ongaroleandro/autonomous-mobile-robot/media/footprint_all_points.png

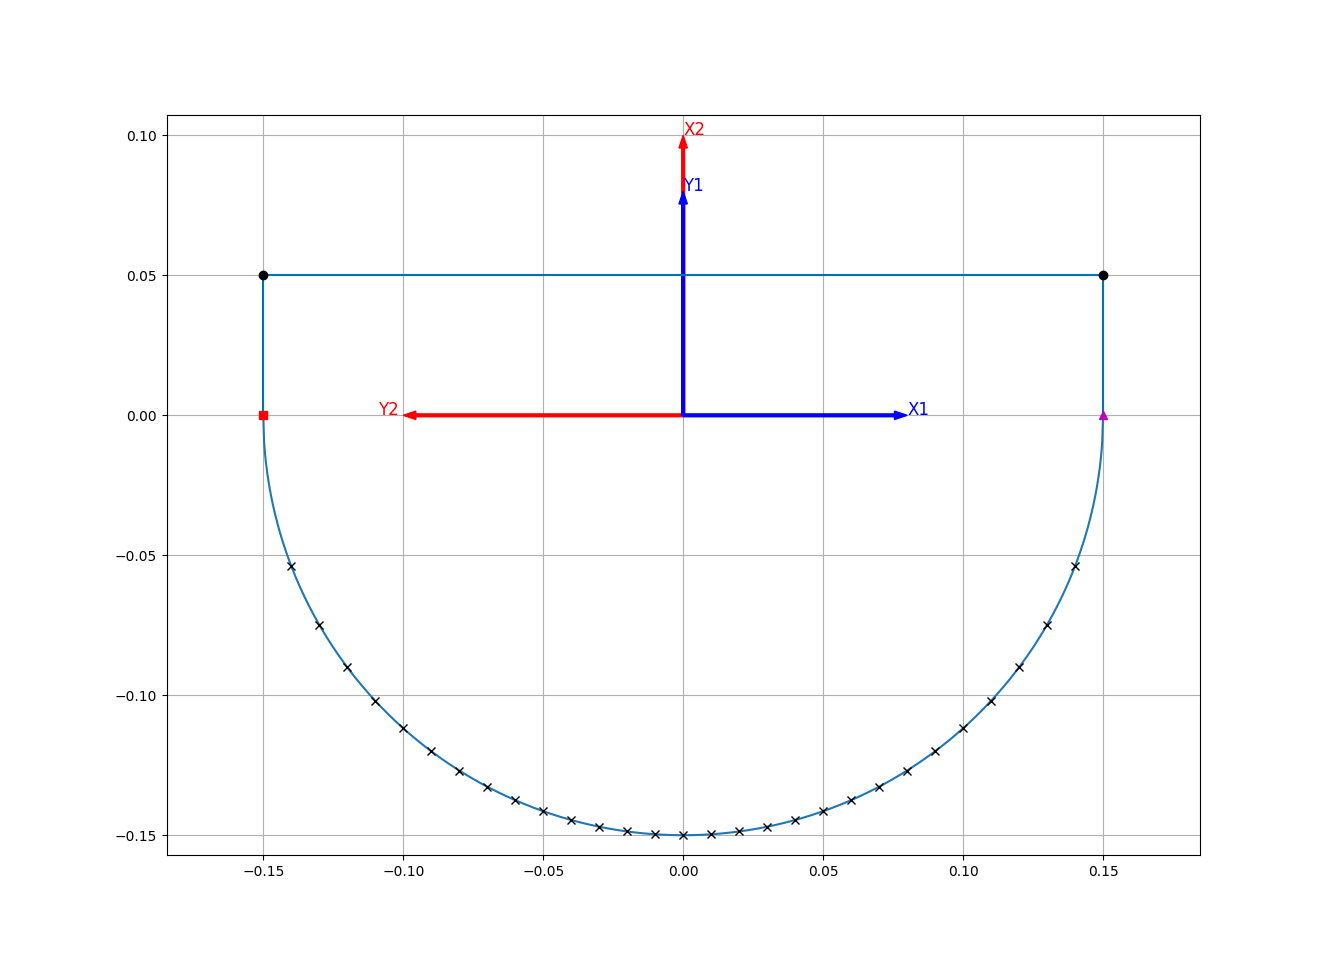
media/footprint_all_points.png
