ongaroleandro/autonomous-mobile-robot/media/footprint_rotmat.png

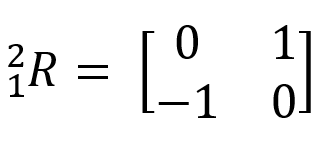
media/footprint_rotmat.png
