ongaroleandro/autonomous-mobile-robot/media/mobile robot v1.jpg

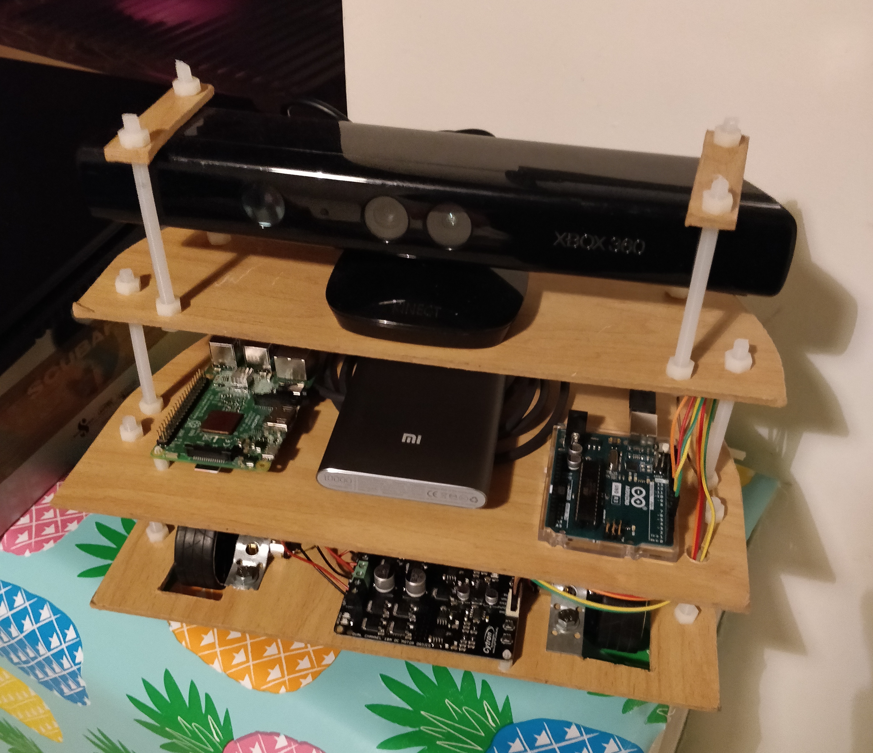
media/mobile robot v1.jpg
