ongaroleandro/autonomous-mobile-robot/media/velocity_vectors.JPG.jpg

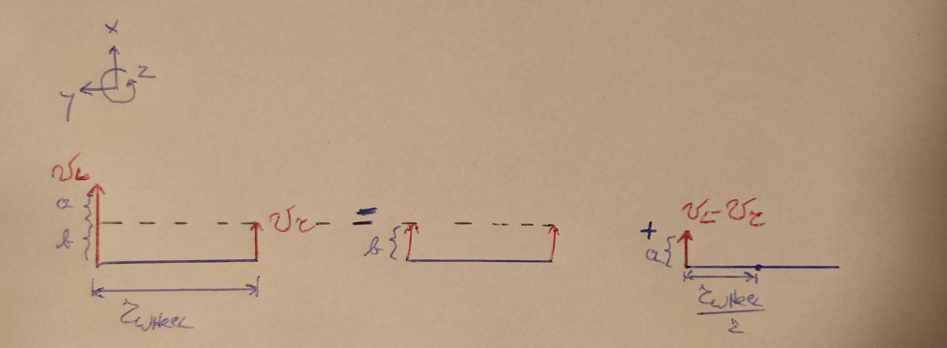
media/velocity_vectors.JPG.jpg
