ongaroleandro/autonomous-mobile-robot/CAD files and technical drawings/bottom plate.PDF

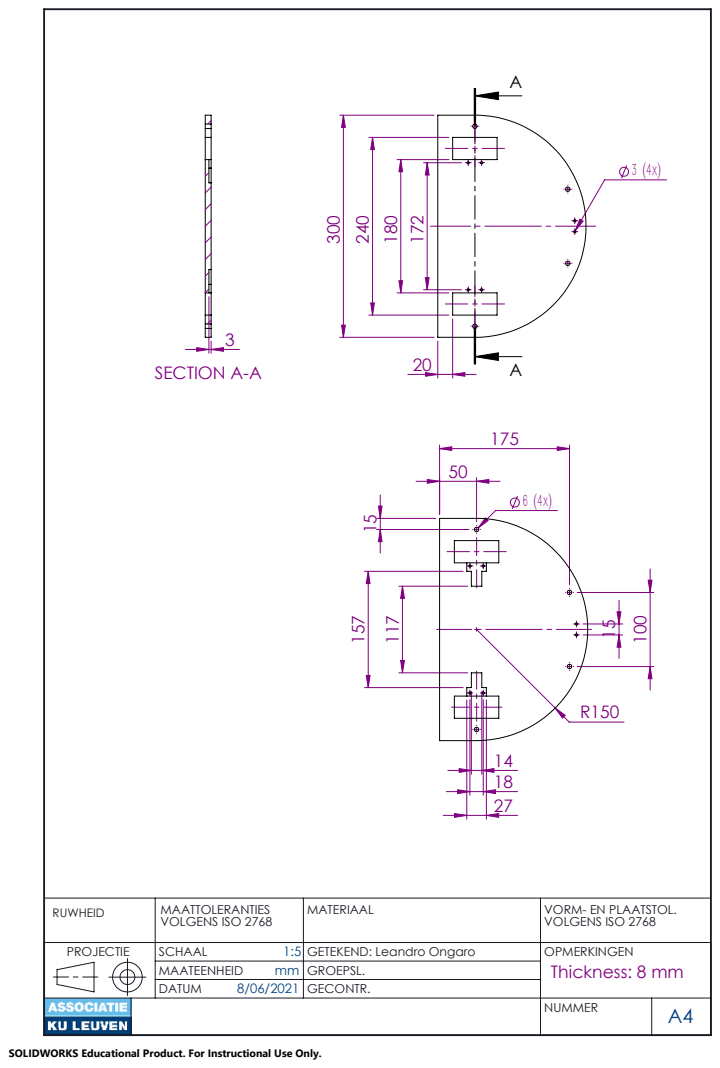
[picture p12: page 1]
SECTION A-A

RUWHEID | MAATTOLERANTIES VOLGENS ISO 2768 | MATERIAAL | VORM- EN PLAATSTOL. VOLGENS ISO 2768
PROJECTIE | SCHAAL 1:5 | GETEKEND: Leandro Ongaro | OPMERKINGEN Thickness: 8 mm

mm MAATEENHEID | GROEPSL.
DATUM 8/06/2021 | GECONTR.

NUMMER | A4

SOLIDWORKS Educational Product. For Instructional Use Only.
