ongaroleandro/autonomous-mobile-robot/CAD files and technical drawings/kinect holder.PDF

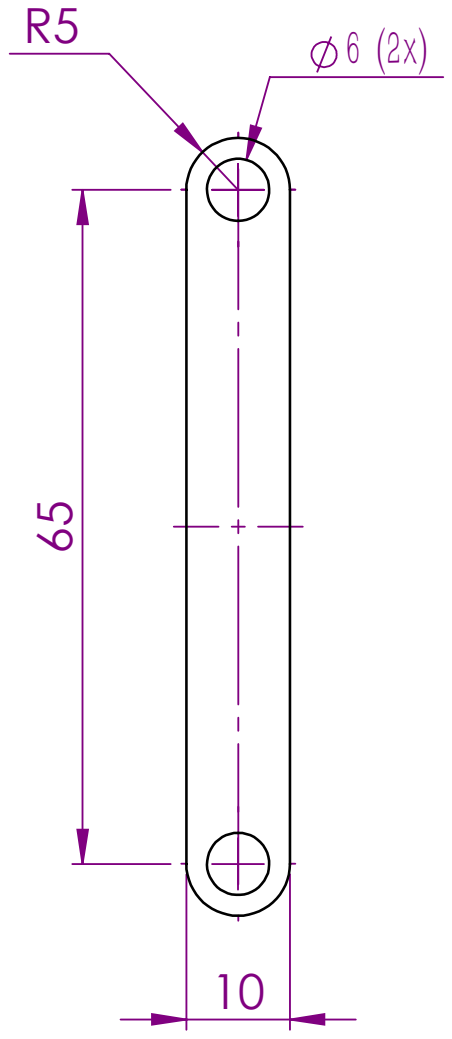
[picture p13: page 1]

RUWHEID | MAATTOLERANTIES VOLGENS ISO 2768 | MATERIAAL | VORM- EN PLAATSTOL. VOLGENS ISO 2768
PROJECTIE | SCHAAL 1:1 | GETEKEND: Leandro Ongaro | OPMERKINGEN Thickness: 3 mm

mm MAATEENHEID | GROEPSL.
DATUM 5/06/2021 | GECONTR.

NUMMER | A4

SOLIDWORKS Educational Product. For Instructional Use Only.
