ongaroleandro/autonomous-mobile-robot/(commit log)

2021-02-28 updated 'communication between RPI and Arduino'
2021-02-28 Added motor-control-mobile-robot.ino and mobile robot v1.jpg
2021-03-01 updated motor-control-mobile-robot.ino
2021-03-04 added node to collect arduino data and updated motor-control-mobile-robot.ino
2021-03-10 changed first remap to camera/depth_registered/image_raw
2021-03-11 added code to read encoders
2021-03-20 only publish topics when encoder is running
2021-03-20 added pose from odometry code
2021-03-20 changed for testing with 'motor-control-and-reading-encoder.ino'
2021-04-10 Reading encoders works correctly now
    Removed MD_REncoder and implemented the encoder library from 1988Kramer.
    Also changed the array (from 5 elements to 3 elements) to accomodate for
    changing to the encoder library from 1988Kramer.
    [motor-control-and-reading-encoder.ino]
2021-04-10 Fixed a mistake when defining the encoder objects
    1140 times two is 2280 and not 2240...
    [motor-control-and-reading-encoder.ino]
2021-04-10 Added reading motor encoders
2021-04-14 Published message now contains usable time in sec.
    nh.now().toSec() is too big for the arduino to handle so for the
    time being we split the number in a hacky way.
    [motor-control-and-reading-encoder.ino]
2021-04-15 Updated code to accept 1x3 array message
    Also added an if statement for when the subscriber node receives
    its first message since we handle sending the time on the arduino
    in a hacky way for the time being.
2021-04-15 Updated reading motor encoders & navigation stack
    Updated the sections 'arduino code for reading motor encoders' and 'first iteration of python code' to the current code.
2021-04-15 Integrated odom publisher in odometry-calculation.py
    This script has the necessary code to publish the odometry we
    calculated.
2021-04-15 Created 'odometry' package
    This package was created because additional dependencies were
    needed to run odometry_handler.py
2021-04-16 Added section on publishing odometry information
2021-04-24 Classes for navigation stack
    Implementation of classes for handling odometry.
2021-04-28 Included freenect_launch
    Instead of launching 'freenect.launch' in a seperate terminal window we launch 'freenect-registered-xyzrgb.launch' from within this launch file.
    By including 'freenect-registered-xyzrgb.launch' we can also run our OdometryHandler (i.e foobar.py)
2021-04-29 Added section:'Calculating the twist from odometry'
    Also updated the 'Publishing odometry information' section.
2021-05-11 Converting speed to a duty cycle is now more correct
    After some testing I found that supplying the motor with
    12 V (so 100% duty cycle) gives a linear velocity of 0.2 m/s.
    6 V (so 50% duty cycle) gives about half the linear velocity.
    So assuming the full range has a linear relationship between duty
    cycle and velocity, I calculated the slope so we can easily convert
    motor speed to a duty cycle.
    [motor-control-and-reading-encoder.ino]
2021-06-04 Final code for publishing odometry
    OdometryHandler.py will start the main odometry handler node.
2021-06-05 Added cad files and technical drawings
2021-06-05 updated several sections
    Text is changed to reflect that we're now using classes for publishing odometry.
    Also added text on the robot design
2021-06-20 Created etbot package and move_base launch file.
    The 'etbot' package is the main package of our robot.
    It has the necessary config files (they end with .yaml) for the navigation stack.
    The package also contains the launch file 'etbot_config'. This file launches the odometry
    node, the rosserial_arduino node, freenect_stack and the static tf broadcaster.
    The move_base launch file start the map_server and AMCL.
2021-06-26 plots used in the wiki page 'footprint calculation'
2021-06-26 Two additional images used in the 'footprint calculation' wiki page
2021-06-26 Updated config files
    costmap_common_params.yaml:
    changed base_footprint to better represent the actual robot footprint
    global_costmap_params.yaml:
    deleted the 'map_type' parameter, since this is not used
2021-06-28 Changed baudrate of rosserial_arduino to 57600.
    Changing baudrate from 115200 to 57600 resolves the check sum error.
    The check sum error was a result of the raspberry not being able
    to keep up because of the high baudrate.
2021-06-28 Cleaned up the code for OdometryHandler_collect_data
    Removed uncommented code
    Tab size across three three files is now consistent (1 tab = 4 spaces)
2021-06-28 Files used to choose a baudrate and calculate the variance
    [data_115200.csv, data_38400.csv, data_57600.csv]
2021-06-28 Code used for wiki page `Footprint calculation`
    This has all the code used to generate the different images as
    well as the code to calculate the point for the footprint
    Uncommenting the various `plt.show()` will give you the different
    images.
2021-06-29 Changed `OdometryHandler.py` and `dataprocessor.py`
    1. Updated the rate in `OdometryHandler.py`
    2. The the angle calculation in `dataprocessor.py` is now done correctly.
    Previously the angle would either become bigger than 360° or become
    smaller than -360°. Now The angle stays between -359° and 359°
2021-06-29 The correct odometry node is now launched.
    Previously `foobar.py` would get launched, but this was the old
    filename of the odometry node. Now `OdometryHandler.py` is launched
    which is the current filename.
2021-06-30 Expanded funcionality
    Regarding the CommandCenter class:
    - added several new instance variables
    - `publish_reset()` now keeps sending the reset message until
    the odom topic values have been reset. Previously this was not the case.
    - added a `createTwistMsg(x, z)` method to generate a Twist message
    with the specified linear and rotational velocity
    - added a `translate()` and `rotate()`method to translate or rotate the robot a
    desired distance or angle. The desired distance or angle is specified by the instance variables `desired_distance` and `desired_angle`
    Also of note, the distance and angle calculation is done by using tf2 listeners.
    -
    Added a `bcolors` class for printing colored text.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
2021-06-30 Moved section to the wiki
    Moved 'Communication between RPI and arduino' to the 'installing the software' wiki page.
2021-07-01 Corrected some incorrect comments
    [motor-control-and-reading-encoder.ino]
2021-07-01 Updated `controlling the motors`
2021-07-01 Added images for explanation in controlling the motors
2021-07-01 Updated Arduino section
    1. added the links to the images for the explanation in `controlling the motors`
    2. updated the section `reading motor encoders`
2021-07-01 Added image for twist calculation from odometry
2021-07-01 Updated odometry section
2021-07-04 Fixed some typos
    `current_ypos` was previously set to the x-position. This has now
    been fixed.
2021-07-04 Updated `controlling the motors` and `base local planner configuration`
